energy-iot/meshems/hardware/ems-carrier/docs/ems-carrier-3d.png

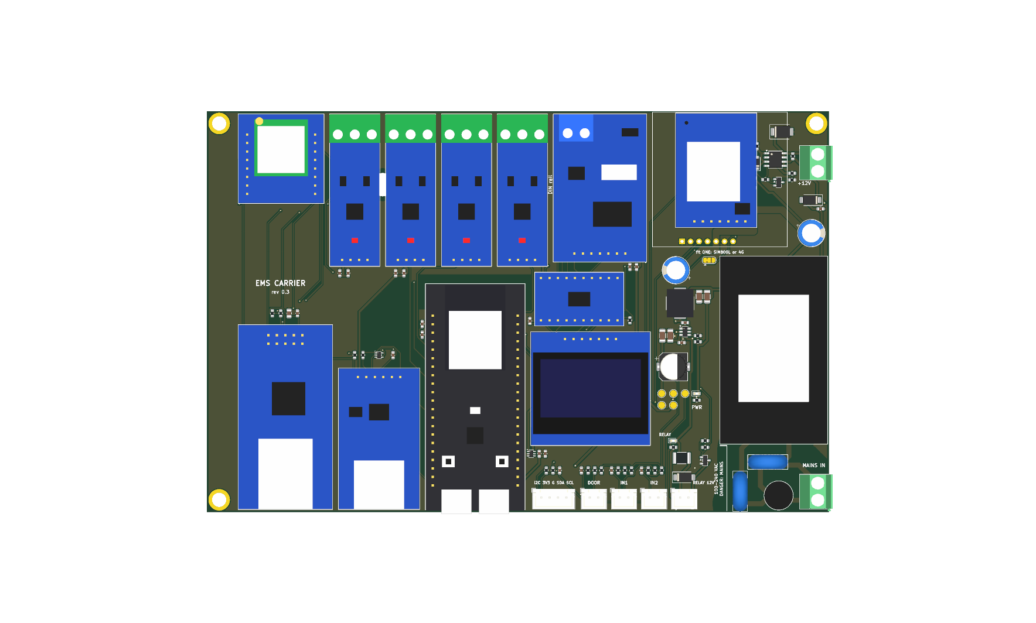
hardware/ems-carrier/docs/ems-carrier-3d.png
