energy-iot/meshems/hardware/ems-carrier/docs/ems-carrier-routed.png

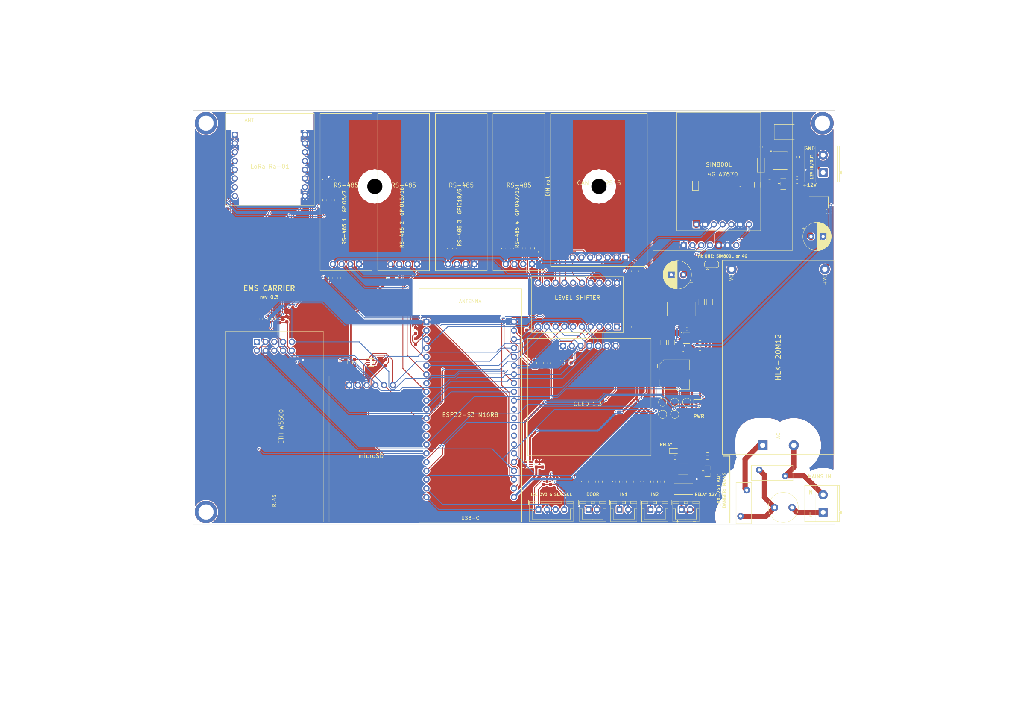
hardware/ems-carrier/docs/ems-carrier-routed.png
