energy-iot/meshems/hardware/ems-carrier/docs/images/ems-carrier-3d-bare.png

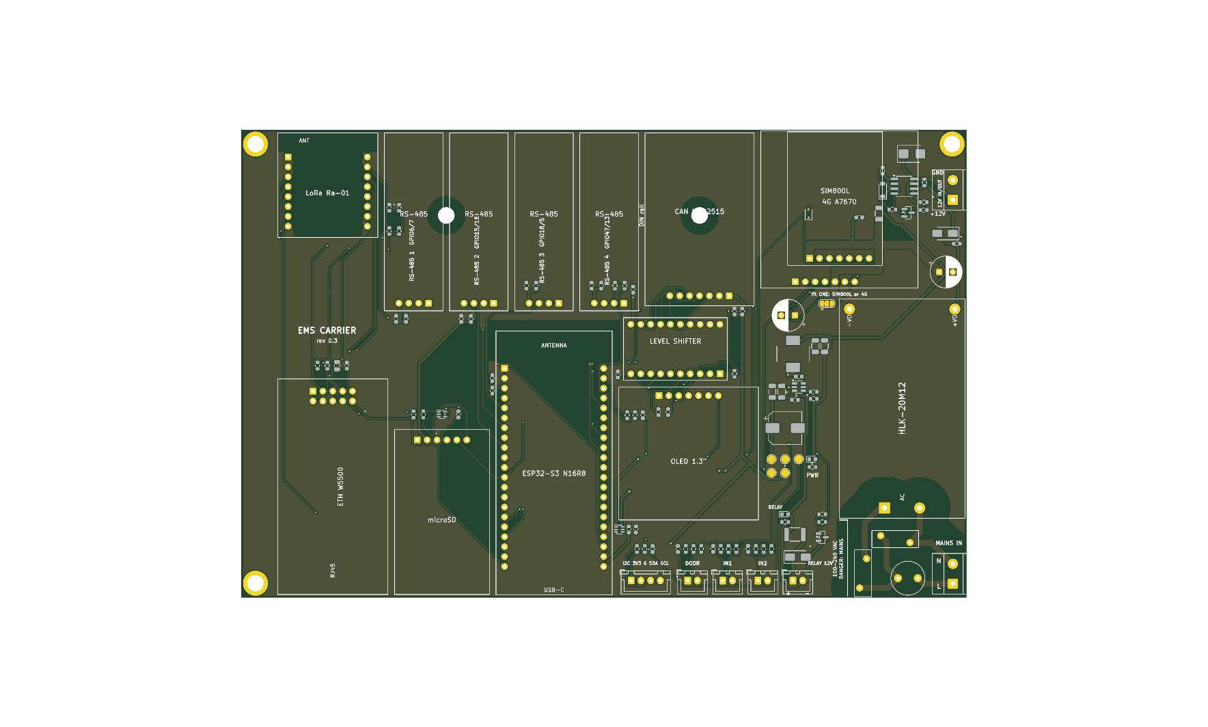
hardware/ems-carrier/docs/images/ems-carrier-3d-bare.png
