energy-iot/meshems/hardware/ems-carrier/fab/bom-jlc.csv

Comment | Designator | Footprint | LCSC Part #
100n | C1,C5,C6,C10,C12,C13,C14,C15,C17,C19,C21,C23,C25,C28,C29,C30,C34,C35,C36,C37,C38,C39 | C_0603_1608Metric | C14663
470u 25V polymer | C2 | CP_Elec_8x10 | C46550466
4.7u 50V | C3,C4 | C_1206_3216Metric | C29823
22u 25V | C7,C8 | C_1206_3216Metric | C12891
10u | C9,C11,C16,C18,C20,C22,C24,C26,C31 | C_0603_1608Metric | C19702
22u | C27 | C_0805_2012Metric | C45783
1000u 10V polymer | C32,C33 | CP_Radial_D8.0mm_P3.50mm | C49232899
SS54 | D1 | D_SMA | C22452
SMBJ16CA | D2 | D_SMB | C113990
BZT52C12 | D3 | D_SOD-123 | C173429
PWR | D4 | LED_0603_1608Metric | C12624
BAT54WS | D5 | D_SOD-323 | C3040452
SS14 | D6 | D_SMA | C2480
RELAY | D7 | LED_0603_1608Metric | C2286
T2A 250V | F1 | Fuse_Littelfuse_372_D8.50mm | C142678
PTC 0.5A 30V | F2 | Fuse_1812_4532Metric | C12559
MAINS L/N/12V IN/OUT | J1,J2 | TerminalBlock_Phoenix_MKDS-1,5-2-5.08_1x02_P5.08mm_Horizontal | C474952
DOOR... | J3,J4,J5,J7 | JST_XH_B2B-XH-A_1x02_P2.50mm_Vertical | C158012
I2C | J6 | JST_XH_B4B-XH-A_1x04_P2.50mm_Vertical | C144395
6.8uH | L1 | L_PROD_PSPMAA0805 | C2962884
HLK-20M12 | PS1 | Converter_ACDC_HLK-20Mxx | C465408
AO4805 | Q1 | SOIC-8_3.9x4.9mm_P1.27mm | C5183840
2N7002 | Q2 | SOT-23 | C8545
AO3400A | Q3 | SOT-23 | C20917
100k | R1,R3,R4,R5,R15,R33 | R_0603_1608Metric | C25803
47k | R2 | R_0603_1608Metric | C25819
73.2k 0.1% | R6 | R_0603_1608Metric | C862276
10k 0.1% | R7 | R_0603_1608Metric | C95204
1k | R8,R13 | R_0603_1608Metric | C21190
10k | R9,R12,R14,R16,R17,R19 | R_0603_1608Metric | C25804
2.2k | R10,R21,R24,R27 | R_0603_1608Metric | C4190
3.9k | R11 | R_0603_1608Metric | C23018
0.1R 1206 | R18 | R_1206_3216Metric | C25334
8.2k | R20 | R_0603_1608Metric | C25981
2.4k | R22 | R_0603_1608Metric | C22940
220 | R23,R26,R29 | R_0603_1608Metric | C22962
5.6k | R25 | R_0603_1608Metric | C23189
13k | R28 | R_0603_1608Metric | C22797
4.7k | R30,R31,R34 | R_0603_1608Metric | C23162
100 | R32 | R_0603_1608Metric | C22775
NTC 5D-9 | RT1 | RV_Disc_D12mm_W4.4mm_P7.5mm | C332361
10D561K | RV1 | RV_Disc_D12mm_W4.4mm_P7.5mm | C2839517
LMR51430XF | U1 | SOT-23-6 | C5219260
LM66100 | U2 | SOT-363_SC-70-6 | C2869734
W5500 module | U11 | W5500_Module_2x05 | C32713306
74LVC1G125 | U13 | SOT-353_SC-70-5 | C52140430
