energy-iot/meshems/hardware/ems-carrier/fab/ems-carrier.step

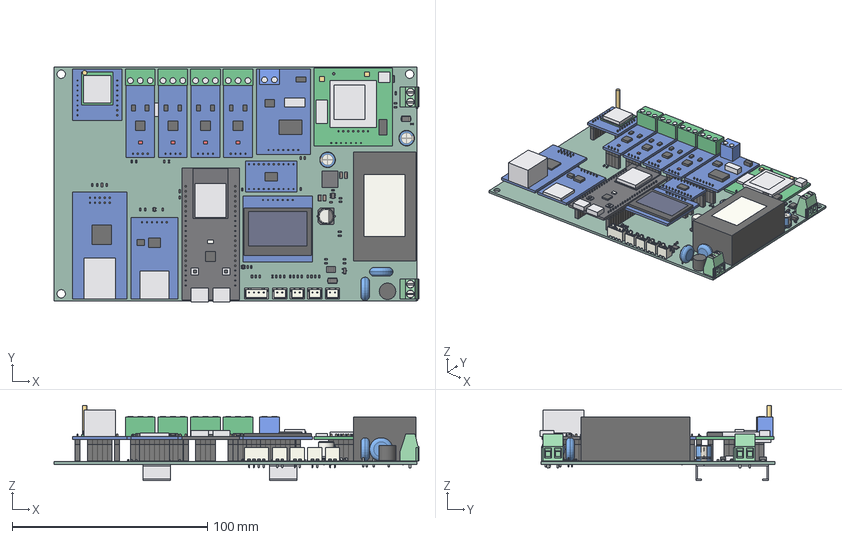
[picture p12: CAD file, 2026-11-11]
hardware/ems-carrier/fab/ems-carrier.step
187.1 x 120.5 x 38.6 mm
JST_B4B_XH_A
C_0603_1608Metric x 31
R_0603_1608Metric x 33
LED_0603_1608Metric x 2
RV_Disc_D12mm_W44mm_P75mm x 2
DIN_Clip_Bud_DNC-4796 0 x 2
HW-519_RS485_Module_1x4 0 x 4
HW-519_RS485_Module_1x4 1 x 4
HW-519_RS485_Module_1x4 2 x 4
HW-519_RS485_Module_1x4 3 x 4
HW-519_RS485_Module_1x4 4 x 4
HW-519_RS485_Module_1x4 5 x 4
HW-519_RS485_Module_1x4 6 x 4
SOT-363_SC-70-6
OLED_1.3in_SPI_1x7 0
OLED_1.3in_SPI_1x7 1
OLED_1.3in_SPI_1x7 2
OLED_1.3in_SPI_1x7 3
OLED_1.3in_SPI_1x7 4
OLED_1.3in_SPI_1x7 5
TXS0108E_Module_2x10_W12.7mm 0
TXS0108E_Module_2x10_W12.7mm 1
TXS0108E_Module_2x10_W12.7mm 2
TXS0108E_Module_2x10_W12.7mm 3
W5500_Module_2x05 0
W5500_Module_2x05 1
W5500_Module_2x05 2
W5500_Module_2x05 3
W5500_Module_2x05 4
CP_Radial_D80mm_P350mm x 2
Converter_ACDC_HLK-20Mxx 0
Converter_ACDC_HLK-20Mxx 1
SOT-23 x 2
Fuse_Littelfuse_372_D8.50mm 0
SIM800L_EVB_1x7 0
SIM800L_EVB_1x7 1
SIM800L_EVB_1x7 2
SIM800L_EVB_1x7 3
SIM800L_EVB_1x7 4
C_0805_2012Metric
SOIC-8_3.9x4.9mm_P1.27mm
SOT-23-6
TerminalBlock_Phoenix_MKDS-1,5-2-5.08_1x02_P5.08mm_Horizontal x 2
D_SMA x 2
Ra-01_Adapter_2x1x8_W20.32mm 0
Ra-01_Adapter_2x1x8_W20.32mm 1
Ra-01_Adapter_2x1x8_W20.32mm 2
Ra-01_Adapter_2x1x8_W20.32mm 3
Ra-01_Adapter_2x1x8_W20.32mm 4
Ra-01_Adapter_2x1x8_W20.32mm 5
C_1206_3216Metric x 4
JST_B2B_XH_A x 4
L_PROD_PSPMAA0805 0
D_SMB
ESP32-S3_DevBoard_2x21_W25.4mm 0
ESP32-S3_DevBoard_2x21_W25.4mm 1
ESP32-S3_DevBoard_2x21_W25.4mm 2
ESP32-S3_DevBoard_2x21_W25.4mm 3
ESP32-S3_DevBoard_2x21_W25.4mm 4
ESP32-S3_DevBoard_2x21_W25.4mm 5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
