energy-iot/meshems/(threads)

Thread 4 (2025-04-21):

Leakage Monitoring

axmsoftware, 2025-04-21:
work with leakage sensor and metering data to create OPENAMI  RCD  Leakage monitoring and command and control 2 way mqtt  - “rcd” or “leakage” subtopic.

Publish every 15 minutes per EMS. this class feeds into OPENAMI top level as new subtopic reporting and alerting leakage . Consider supporting some persistent data so can run a rule if leakage is changing over time then ralays e call to action alert.

Thread 6 (2025-04-21):

Meter Integration

axmsoftware, 2025-04-21:
Create a Meter DDS328 modbus device type class that has the modbus register suite declared and some supporting methods for loop data collection, openami subtopic structure to mqtt -different subtopics should publish at different rates , and oled UX  summary, and a diagnostic test method for each modbus device that can map to a diagnostic test button for example -? Just need framework as let workshop developers form teams around code energy iot challenges. Use Chatgpt or equiv to create a framework class and ingest the mfr’s PDF of the register set to create a code Class framework. Class should include putter and getter methods.  a few registers to be frequently queried as part of  a diagnostic method (leave empty for hackathon developer to fill in)

Thread 8 (2025-04-21):

Policy Watcher - ESP32S3 policy watch loop

axmsoftware, 2025-04-21:
Create a policy watch loop that is able to receive or defaults each tenant to a time of use entry policy overwatch.
If it detect over policy then can send alerts , if persists then can cut power after certain time.

Thread 9 (2025-04-21):

Policy Watcher - Flexmeasure ESP32S3 fan-in

axmsoftware, 2025-04-21:
Create a[ Flexmeasures ](https://github.com/flexmeasures/)fanin policy enforcement controller time of use based policy enforcements

To Help Glenn Algie and Doug MEndonca have put a detailed design code framework together using ChatGPT training of FLexmeasures.
It can be found here on[ Google shared docs](https://docs.google.com/document/d/1WiTW9lSyz2ARrED2CXFrpDBbTb_VonN_YJp-jVFDumc/edit?usp=sharing)

Thread 13 (2025-09-01):

Hardware Stability and Sustainability

axmsoftware, 2025-09-01:
There were in total 15 meshEMS HW gateways developed for the Energy Hackathon back in April.
Those were put together with volunteer work by hand by NESL.energy and Ampra Grid.
The defect rate reported was at 20% which has prompted an evaluation of the design so it can scale better and the defect rate can be reduced if not eliminated.

This is a top-level issue to record and prioritize issues related to the gateway design, repeatability and sustainability in the face of evolving supply chains and tariff challenges.
