energy-iot/meshems/hardware/ems-carrier/kicad/ems-carrier.kicad_pcb

## KiCad design hardware/ems-carrier/kicad/ems-carrier.kicad_pcb (2026-11-11)

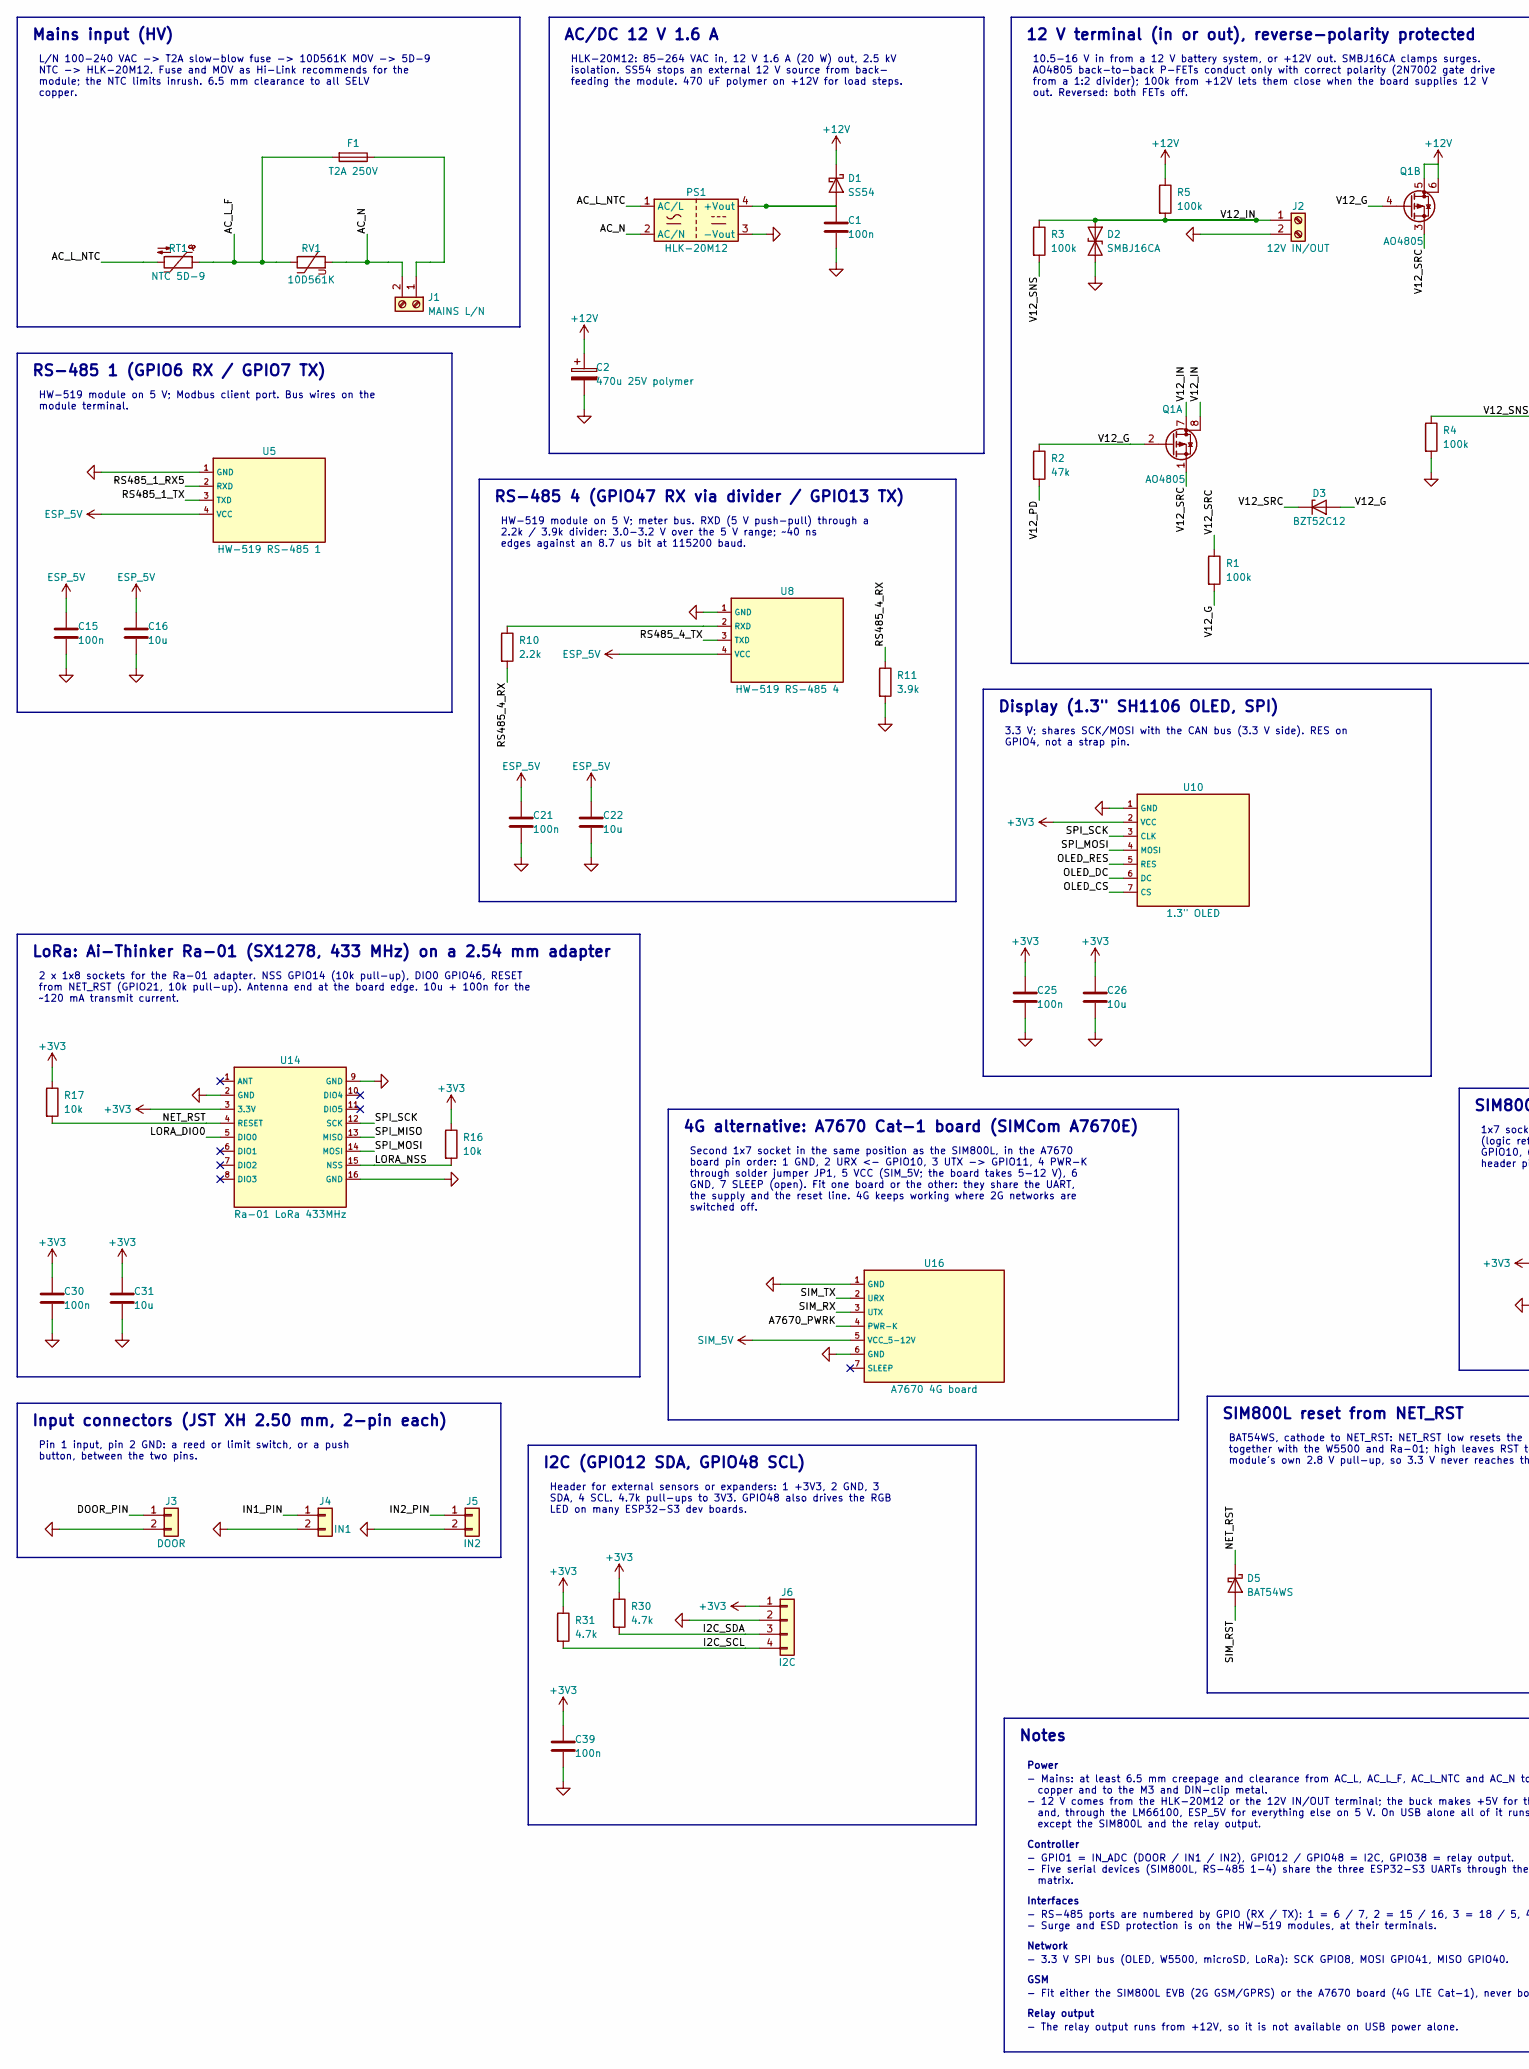
[picture p39: schematic ems-carrier.kicad_sch, EMS carrier, part in row 1, column 1]

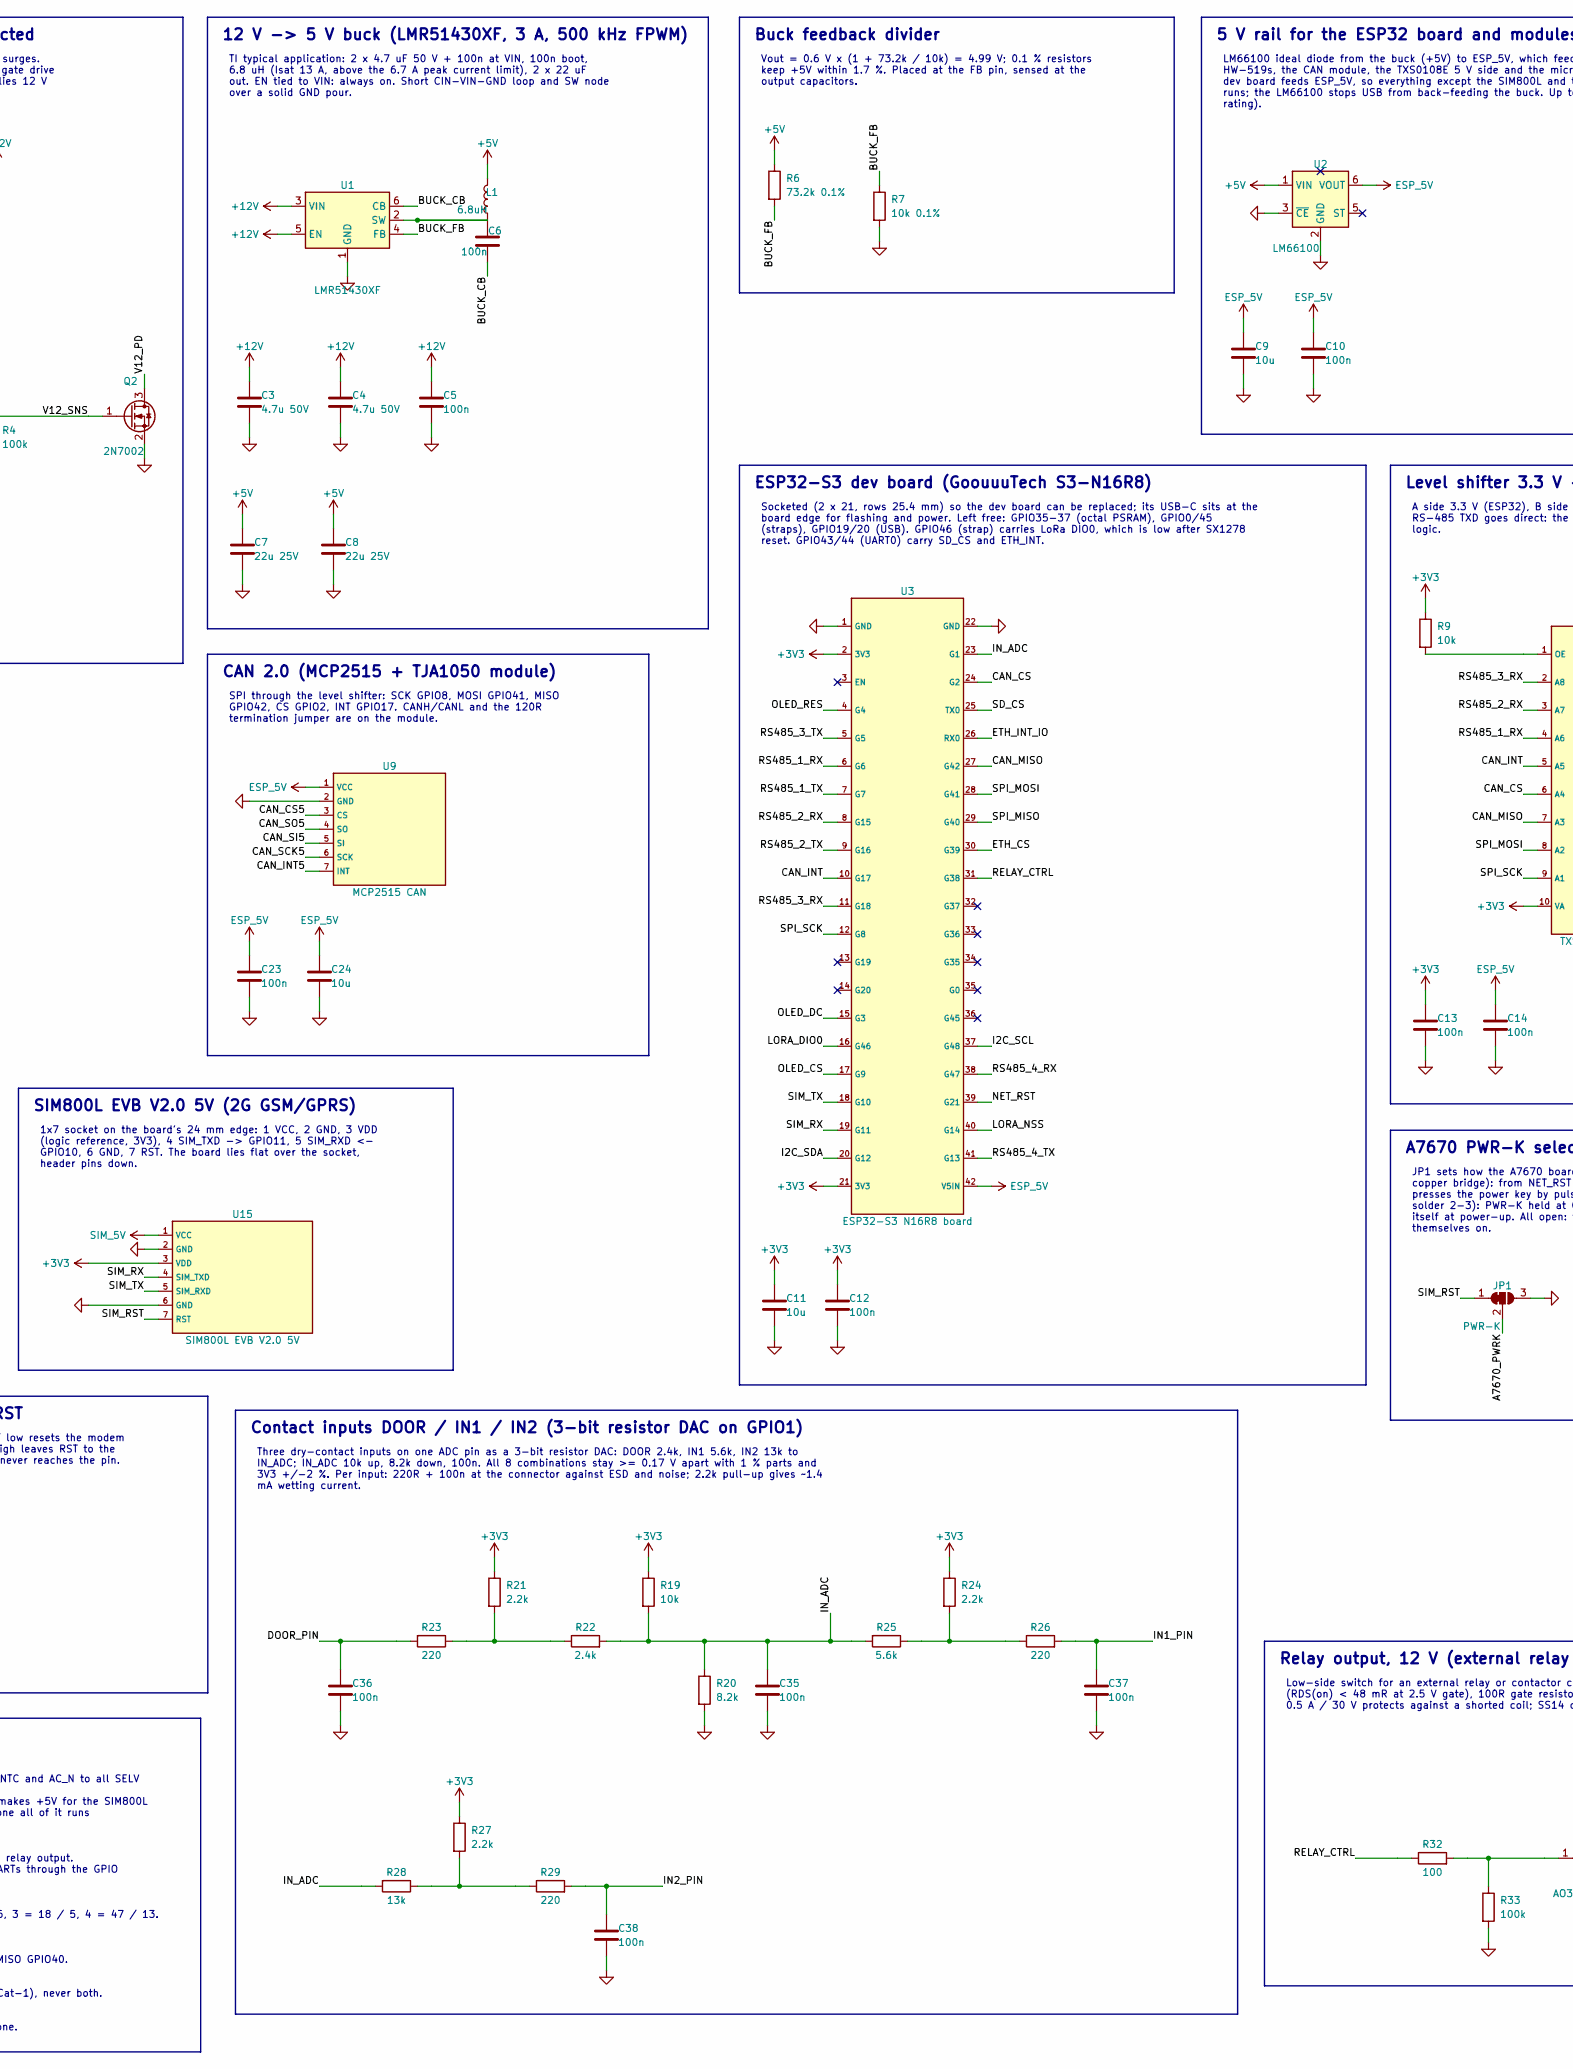
[picture p40: schematic ems-carrier.kicad_sch, EMS carrier, part in row 1, column 2]

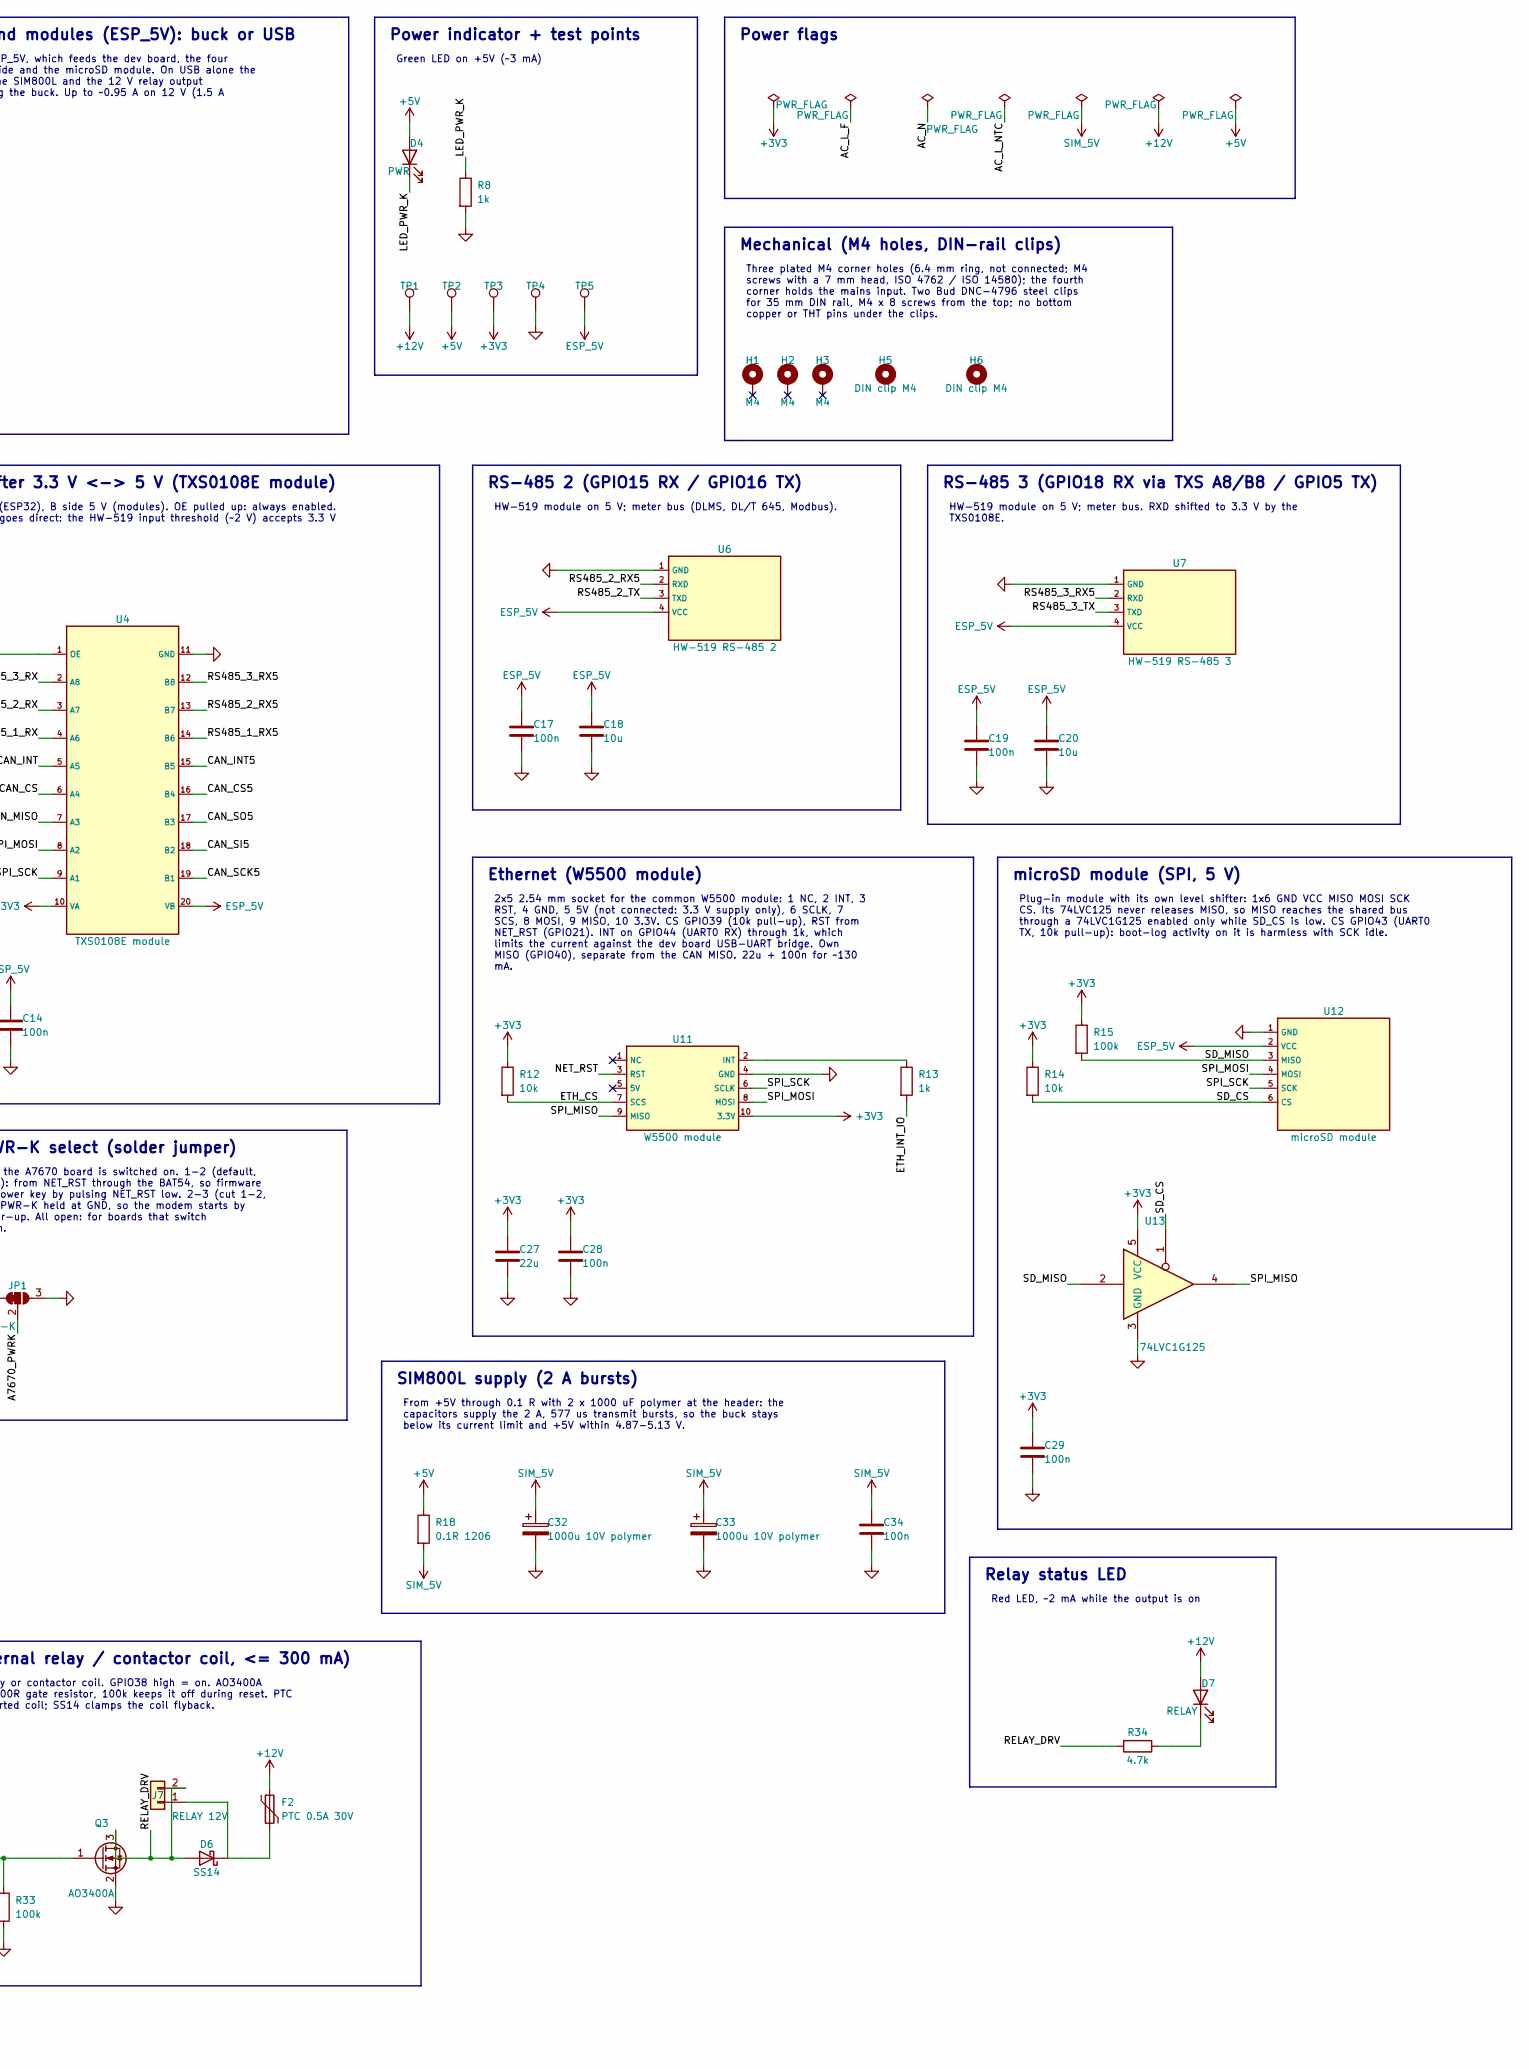
[picture p41: schematic ems-carrier.kicad_sch, EMS carrier, part in row 1, column 3]

Parts:
C1, C5, C6, C10, C12, C13, C14, C15, C17, C19, C21, C23, C25, C28, C29, C30, C34, C35, C36, C37, C38, C39: 100n; C_0603_1608Metric; LCSC C14663
C2: 470u 25V polymer; CP_Elec_8x10; MPN jieerrui MA25V470M8x10 (polymer, 25 mR); LCSC C46550466
C3, C4: 4.7u 50V; C_1206_3216Metric; LCSC C29823
C7, C8: 22u 25V; C_1206_3216Metric; LCSC C12891
C9, C11, C16, C18, C20, C22, C24, C26, C31: 10u; C_0603_1608Metric; LCSC C19702
C27: 22u; C_0805_2012Metric; LCSC C45783
C32, C33: 1000u 10V polymer; CP_Radial_D8.0mm_P3.50mm; MPN jieerrui PA10V1000M8X11 (polymer, 14 mR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; LCSC C49232899
D1: SS54; D_SMA; LCSC C22452
D2: SMBJ16CA; D_SMB; LCSC C113990
D3: BZT52C12; D_SOD-123; LCSC C173429
D4: PWR; LED_0603_1608Metric; LCSC C12624
D5: BAT54WS; D_SOD-323; LCSC C3040452
D6: SS14; D_SMA; LCSC C2480
D7: RELAY; LED_0603_1608Metric; LCSC C2286
F1: T2A 250V; Fuse_Littelfuse_372_D8.50mm; MPN Littelfuse 39212000000 (TR5 time-lag 2 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; LCSC C142678
F2: PTC 0.5A 30V; Fuse_1812_4532Metric; MPN RUILON SMD1812P050TF/30 (0.5 A hold, 1 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; LCSC C12559
H1, H2, H3: M4; MountingHole_4.3mm_M4_Pad6.4
H5, H6: DIN clip M4; DIN_Clip_Bud_DNC-4796
J1: MAINS L/N; TerminalBlock_Phoenix_MKDS-1,5-2-5.08_1x02_P5.08mm_Horizont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; LCSC C474952
J2: 12V IN/OUT; TerminalBlock_Phoenix_MKDS-1,5-2-5.08_1x02_P5.08mm_Horizont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; LCSC C474952
J3: DOOR; JST_XH_B2B-XH-A_1x02_P2.50mm_Vertical; MPN JST B2B-XH-A(LF)(SN); LCSC C158012
J4: IN1; JST_XH_B2B-XH-A_1x02_P2.50mm_Vertical; MPN JST B2B-XH-A(LF)(SN); LCSC C158012
J5: IN2; JST_XH_B2B-XH-A_1x02_P2.50mm_Vertical; MPN JST B2B-XH-A(LF)(SN); LCSC C158012
J6: I2C; JST_XH_B4B-XH-A_1x04_P2.50mm_Vertical; MPN JST B4B-XH-A(LF)(SN); LCSC C144395
J7: RELAY 12V; JST_XH_B2B-XH-A_1x02_P2.50mm_Vertical; MPN JST B2B-XH-A(LF)(SN); LCSC C158012
JP1: PWR-K; SolderJumper-3_P1.3mm_Bridged12_RoundedPad1.0x1.5mm
L1: 6.8uH; L_PROD_PSPMAA0805; MPN PROD PSPMAA0805-6R8M-ANP (19 mR, Isat 1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; LCSC C2962884
PS1: HLK-20M12; Converter_ACDC_HLK-20Mxx; LCSC C465408
Q1: AO4805; SOIC-8_3.9x4.9mm_P1.27mm; LCSC C5183840
Q2: 2N7002; SOT-23; LCSC C8545
Q3: AO3400A; SOT-23; LCSC C20917
R1, R3, R4, R5, R15, R33: 100k; R_0603_1608Metric; LCSC C25803
R2: 47k; R_0603_1608Metric; LCSC C25819
R6: 73.2k 0.1%; R_0603_1608Metric; LCSC C862276
R7: 10k 0.1%; R_0603_1608Metric; LCSC C95204
R8, R13: 1k; R_0603_1608Metric; LCSC C21190
R9, R12, R14, R16, R17, R19: 10k; R_0603_1608Metric; LCSC C25804
R10, R21, R24, R27: 2.2k; R_0603_1608Metric; LCSC C4190
R11: 3.9k; R_0603_1608Metric; LCSC C23018
R18: 0.1R 1206; R_1206_3216Metric; MPN UNI-ROYAL 1206W4F100LT5E (0.25 W); LCSC C25334
R20: 8.2k; R_0603_1608Metric; LCSC C25981
R22: 2.4k; R_0603_1608Metric; LCSC C22940
R23, R26, R29: 220; R_0603_1608Metric; LCSC C22962
R25: 5.6k; R_0603_1608Metric; LCSC C23189
R28: 13k; R_0603_1608Metric; LCSC C22797
R30, R31, R34: 4.7k; R_0603_1608Metric; LCSC C23162
R32: 100; R_0603_1608Metric; LCSC C22775
RT1: NTC 5D-9; RV_Disc_D12mm_W4.4mm_P7.5mm; MPN Hongzhi 5D-9 (5 R, 3 A, 9 mm disc, P 7.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; LCSC C332361
RV1: 10D561K; RV_Disc_D12mm_W4.4mm_P7.5mm; LCSC C2839517
TP1: +12V; TestPoint_Pad_D2.0mm
TP2: +5V; TestPoint_Pad_D2.0mm
TP3: +3V3; TestPoint_Pad_D2.0mm
TP4: GND; TestPoint_Pad_D2.0mm
TP5: ESP_5V; TestPoint_Pad_D2.0mm
U1: LMR51430XF; SOT-23-6; LCSC C5219260
U2: LM66100; SOT-363_SC-70-6; LCSC C2869734
U3: ESP32-S3 N16R8 board; ESP32-S3_DevBoard_2x21_W25.4mm
U4: TXS0108E module; TXS0108E_Module_2x10_W12.7mm
U5: HW-519 RS-485 1; HW-519_RS485_Module_1x4
U6: HW-519 RS-485 2; HW-519_RS485_Module_1x4
U7: HW-519 RS-485 3; HW-519_RS485_Module_1x4
U8: HW-519 RS-485 4; HW-519_RS485_Module_1x4
U9: MCP2515 CAN; MCP2515_CAN_Module_1x7
U10: 1.3" OLED; OLED_1.3in_SPI_1x7
U11: W5500 module; W5500_Module_2x05; LCSC C32713306
U12: microSD module; microSD_Module_1x6
U13: 74LVC1G125; SOT-353_SC-70-5; LCSC C52140430
U14: Ra-01 LoRa 433MHz; Ra-01_Adapter_2x1x8_W20.32mm
U15: SIM800L EVB V2.0 5V; SIM800L_EVB_1x7
U16: A7670 4G board; A7670_4G_Board_1x7

Connections:
+3V3: C11.1, C12.1, C13.1, C25.1, C26.1, C27.1, C28.1, C29.1, C30.1, C31.1, C39.1, J6.1, R9.1, R12.1, R14.1, R15.1, R16.1, R17.1, R19.1, R21.1, R24.1, R27.1, R30.1, R31.1, TP3.1, U3.2 (3V3), U3.21 (3V3), U4.10 (VA), U10.2 (VCC), U11.10 (3.3V), U13.5 (VCC), U14.3 (3.3V), U15.3 (VDD)
+5V: C7.1, C8.1, D4.2 (A), L1.2, R6.1, R18.1, TP2.1, U2.1 (VIN)
+12V: C2.1, C3.1, C4.1, C5.1, D1.1 (K), D7.2 (A), F2.1, Q1.5 (D), Q1.6 (D), R5.1, TP1.1, U1.3 (VIN), U1.5 (EN)
/A7670_PWRK: JP1.2 (C), U16.4 (PWR-K)
/AC_L_F: F1.2, RT1.1, RV1.1
/AC_L_NTC: PS1.1 (AC/L), RT1.2
/AC_N: J1.2, PS1.2 (AC/N), RV1.2
/BUCK_CB: C6.1, U1.6 (CB)
/BUCK_FB: R6.2, R7.1, U1.4 (FB)
/CAN_CS: U3.24 (G2), U4.6 (A4)
/CAN_CS5: U4.16 (B4), U9.3 (CS)
/CAN_INT: U3.10 (G17), U4.5 (A5)
/CAN_INT5: U4.15 (B5), U9.7 (INT)
/CAN_MISO: U3.27 (G42), U4.7 (A3)
/CAN_SCK5: U4.19 (B1), U9.6 (SCK)
/CAN_SI5: U4.18 (B2), U9.5 (SI)
/CAN_SO5: U4.17 (B3), U9.4 (SO)
/DOOR_PIN: C36.1, J3.1, R23.2
/ETH_CS: R12.2, U3.30 (G39), U11.7 (SCS)
/ETH_INT_IO: R13.2, U3.26 (RX0)
/I2C_SCL: J6.4, R31.2, U3.37 (G48)
/I2C_SDA: J6.3, R30.2, U3.20 (G12)
/IN1_PIN: C37.1, J4.1, R26.2
/IN2_PIN: C38.1, J5.1, R29.2
/IN_ADC: C35.1, R19.2, R20.1, R22.2, R25.2, R28.2, U3.23 (G1)
/LED_PWR_K: D4.1 (K), R8.1
/LORA_DIO0: U3.16 (G46), U14.5 (DIO0)
/LORA_NSS: R16.2, U3.40 (G14), U14.15 (NSS)
/NET_RST: D5.1 (K), R17.2, U3.39 (G21), U11.3 (RST), U14.4 (RESET)
/OLED_CS: U3.17 (G9), U10.7 (CS)
/OLED_DC: U3.15 (G3), U10.6 (DC)
/OLED_RES: U3.4 (G4), U10.5 (RES)
/RELAY_CTRL: R32.1, U3.31 (G38)
/RELAY_DRV: D6.2 (A), J7.2, Q3.3 (D), R34.2
/RS485_1_RX: U3.6 (G6), U4.4 (A6)
/RS485_1_RX5: U4.14 (B6), U5.2 (RXD)
/RS485_1_TX: U3.7 (G7), U5.3 (TXD)
/RS485_2_RX: U3.8 (G15), U4.3 (A7)
/RS485_2_RX5: U4.13 (B7), U6.2 (RXD)
/RS485_2_TX: U3.9 (G16), U6.3 (TXD)
/RS485_3_RX: U3.11 (G18), U4.2 (A8)
/RS485_3_RX5: U4.12 (B8), U7.2 (RXD)
/RS485_3_TX: U3.5 (G5), U7.3 (TXD)
/RS485_4_RX: R10.2, R11.1, U3.38 (G47)
/RS485_4_TX: U3.41 (G13), U8.3 (TXD)
/SD_CS: R14.2, U3.25 (TX0), U12.6 (CS), U13.1
/SD_MISO: R15.2, U12.3 (MISO), U13.2
/SIM_RST: D5.2 (A), JP1.1 (A), U15.7 (RST)
/SIM_RX: U3.19 (G11), U15.4 (SIM_TXD), U16.3 (UTX)
/SIM_TX: U3.18 (G10), U15.5 (SIM_RXD), U16.2 (URX)
/SPI_MISO: U3.29 (G40), U11.9 (MISO), U13.4, U14.13 (MISO)
/SPI_MOSI: U3.28 (G41), U4.8 (A2), U10.4 (MOSI), U11.8 (MOSI), U12.4 (MOSI), U14.14 (MOSI)
/SPI_SCK: U3.12 (G8), U4.9 (A1), U10.3 (CLK), U11.6 (SCLK), U12.5 (SCK), U14.12 (SCK)
/V12_G: D3.2 (A), Q1.2 (G), Q1.4 (G), R1.2, R2.1
/V12_IN: D2.1 (A1), J2.1, Q1.7 (D), Q1.8 (D), R3.1, R5.2
/V12_PD: Q2.3 (D), R2.2
/V12_SNS: Q2.1 (G), R3.2, R4.1
/V12_SRC: D3.1 (K), Q1.1 (S), Q1.3 (S), R1.1
ESP_5V: C9.1, C10.1, C14.1, C15.1, C16.1, C17.1, C18.1, C19.1, C20.1, C21.1, C22.1, C23.1, C24.1, TP5.1, U2.6 (VOUT), U3.42 (V5IN), U4.20 (VB), U5.4 (VCC), U6.4 (VCC), U7.4 (VCC), U8.4 (VCC), U9.1 (VCC), U12.2 (VCC)
GND: C1.2, C2.2, C3.2, C4.2, C5.2, C7.2, C8.2, C9.2, C10.2, C11.2, C12.2, C13.2, C14.2, C15.2, C16.2, C17.2, C18.2, C19.2, C20.2, C21.2, C22.2, C23.2, C24.2, C25.2, C26.2, C27.2, C28.2, C29.2, C30.2, C31.2, C32.2, C33.2, C34.2, C35.2, C36.2, C37.2, C38.2, C39.2, D2.2 (A2), J2.2, J3.2, J4.2, J5.2, J6.2, JP1.3 (B), PS1.3 (-Vout), Q2.2 (S), Q3.2 (S), R4.2, R7.2, R8.2, R11.2, R20.2, R33.2, TP4.1, U1.1 (GND), U2.2 (GND), U2.3 (~CE), U3.1 (GND), U3.22 (GND), U4.11 (GND), U5.1 (GND), U6.1 (GND), U7.1 (GND), U8.1 (GND), U9.2 (GND), U10.1 (GND), U11.4 (GND), U12.1 (GND), U13.3 (GND), U14.2 (GND), U14.9 (GND), U14.16 (GND), U15.2 (GND), U15.6 (GND), U16.1 (GND), U16.6 (GND)
unnamed: C1.1, D1.2 (A), PS1.4 (+Vout)
unnamed: D6.1 (K), F2.2, J7.1
unnamed: D7.1 (K), R34.1
unnamed: F1.1, J1.1
unnamed: Q3.1 (G), R32.2, R33.1
unnamed: R21.2, R22.1, R23.1
unnamed: R24.2, R25.1, R26.1
unnamed: R27.2, R28.1, R29.1
unnamed: C6.2, L1.1, U1.2 (SW)
unnamed: R9.2, U4.1 (OE)
unnamed: R10.1, U8.2 (RXD)
unnamed: R13.1, U11.2 (INT)
SIM_5V: C32.1, C33.1, C34.1, R18.2, U15.1 (VCC), U16.5 (VCC_5-12V)

Notes on the sheet:
Mains input (HV)
L/N 100-240 VAC -> T2A slow-blow fuse -> 10D561K MOV -> 5D-9 NTC -> HLK-20M12. Fuse and MOV as Hi-Link recommends for the module; the NTC limits inrush. 6.5 mm clearance to all SELV copper.
AC/DC 12 V 1.6 A
HLK-20M12: 85-264 VAC in, 12 V 1.6 A (20 W) out, 2.5 kV isolation. SS54 stops an external 12 V source from back- feeding the module. 470 uF polymer on +12V for load steps.
12 V terminal (in or out), reverse-polarity protected
10.5-16 V in from a 12 V battery system, or +12V out. SMBJ16CA clamps surges. AO4805 back-to-back P-FETs conduct only with correct polarity (2N7002 gate drive from a 1:2 divider); 100k from +12V lets them close when the board supplies 12 V out. Reversed: both FETs off.
12 V -> 5 V buck (LMR51430XF, 3 A, 500 kHz FPWM)
TI typical application: 2 x 4.7 uF 50 V + 100n at VIN, 100n boot, 6.8 uH (Isat 13 A, above the 6.7 A peak current limit), 2 x 22 uF out. EN tied to VIN: always on. Short CIN-VIN-GND loop and SW node over a solid GND pour.
Buck feedback divider
Vout = 0.6 V x (1 + 73.2k / 10k) = 4.99 V; 0.1 % resistors keep +5V within 1.7 %. Placed at the FB pin, sensed at the output capacitors.
5 V rail for the ESP32 board and modules (ESP_5V): buck or USB
LM66100 ideal diode from the buck (+5V) to ESP_5V, which feeds the dev board, the four HW-519s, the CAN module, the TXS0108E 5 V side and the microSD module. On USB alone the dev board feeds ESP_5V, so everything except the SIM800L and the 12 V relay output runs; the LM66100 stops USB from back-fee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
Power indicator + test points
Green LED on +5V (~3 mA)
Power flags
Mechanical (M4 holes, DIN-rail clips)
Three plated M4 corner holes (6.4 mm ring, not connected; M4 screws with a 7 mm head, ISO 4762 / ISO 14580); the fourth corner holds the mains input. Two Bud DNC-4796 steel clips for 35 mm DIN rail, M4 x 8 screws from the top; no bottom copper or THT pins under the clips.
ESP32-S3 dev board (GoouuuTech S3-N16R8)
Socketed (2 x 21, rows 25.4 mm) so the dev board can be replaced; its USB-C sits at the board edge for flashing and power. Left free: GPIO35-37 (octal PSRAM), GPIO0/45 (straps), GPIO19/20 (USB). GPIO46 (strap) carries LoRa DIO0, which is low after SX1278 reset. GPIO43/44 (UART0) carry SD_CS and ETH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
Level shifter 3.3 V <-> 5 V (TXS0108E module)
A side 3.3 V (ESP32), B side 5 V (modules). OE pulled up: always enabled. RS-485 TXD goes direct: the HW-519 input threshold (~2 V) accepts 3.3 V logic.
RS-485 1 (GPIO6 RX / GPIO7 TX)
HW-519 module on 5 V; Modbus client port. Bus wires on the module terminal.
RS-485 2 (GPIO15 RX / GPIO16 TX)
HW-519 module on 5 V; meter bus (DLMS, DL/T 645, Modbus).
RS-485 3 (GPIO18 RX via TXS A8/B8 / GPIO5 TX)
HW-519 module on 5 V; meter bus. RXD shifted to 3.3 V by the TXS0108E.
RS-485 4 (GPIO47 RX via divider / GPIO13 TX)
HW-519 module on 5 V; meter bus. RXD (5 V push-pull) through a 2.2k / 3.9k divider: 3.0-3.2 V over the 5 V range; ~40 ns edges against an 8.7 us bit at 115200 baud.
CAN 2.0 (MCP2515 + TJA1050 module)
SPI through the level shifter: SCK GPIO8, MOSI GPIO41, MISO GPIO42, CS GPIO2, INT GPIO17. CANH/CANL and the 120R termination jumper are on the module.
Display (1.3" SH1106 OLED, SPI)
3.3 V; shares SCK/MOSI with the CAN bus (3.3 V side). RES on GPIO4, not a strap pin.
Ethernet (W5500 module)
2x5 2.54 mm socket for the common W5500 module: 1 NC, 2 INT, 3 RST, 4 GND, 5 5V (not connected: 3.3 V supply only), 6 SCLK, 7 SCS, 8 MOSI, 9 MISO, 10 3.3V. CS GPIO39 (10k pull-up), RST from NET_RST (GPIO21). INT on GPIO44 (UART0 RX) through 1k, which limits the current against the dev board USB-UAR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
microSD module (SPI, 5 V)
Plug-in module with its own level shifter: 1x6 GND VCC MISO MOSI SCK CS. Its 74LVC125 never releases MISO, so MISO reaches the shared bus through a 74LVC1G125 enabled only while SD_CS is low. CS GPIO43 (UART0 TX, 10k pull-up): boot-log activity on it is harmless with SCK idle.
LoRa: Ai-Thinker Ra-01 (SX1278, 433 MHz) on a 2.54 mm adapter
2 x 1x8 sockets for the Ra-01 adapter. NSS GPIO14 (10k pull-up), DIO0 GPIO46, RESET from NET_RST (GPIO21, 10k pull-up). Antenna end at the board edge. 10u + 100n for the ~120 mA transmit current.
SIM800L EVB V2.0 5V (2G GSM/GPRS)
1x7 socket on the board's 24 mm edge: 1 VCC, 2 GND, 3 VDD (logic reference, 3V3), 4 SIM_TXD -> GPIO11, 5 SIM_RXD <- GPIO10, 6 GND, 7 RST. The board lies flat over the socket, header pins down.
4G alternative: A7670 Cat-1 board (SIMCom A7670E)
Second 1x7 socket in the same position as the SIM800L, in the A7670 board pin order: 1 GND, 2 URX <- GPIO10, 3 UTX -> GPIO11, 4 PWR-K through solder jumper JP1, 5 VCC (SIM_5V; the board takes 5-12 V), 6 GND, 7 SLEEP (open). Fit one board or the other: they share the UART, the supply and the reset l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
A7670 PWR-K select (solder jumper)
JP1 sets how the A7670 board is switched on. 1-2 (default, copper bridge): from NET_RST through the BAT54, so firmware presses the power key by pulsing NET_RST low. 2-3 (cut 1-2, solder 2-3): PWR-K held at GND, so the modem starts by itself at power-up. All open: for boards that switch themselves o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
SIM800L supply (2 A bursts)
From +5V through 0.1 R with 2 x 1000 uF polymer at the header: the capacitors supply the 2 A, 577 us transmit bursts, so the buck stays below its current limit and +5V within 4.87-5.13 V.
SIM800L reset from NET_RST
BAT54WS, cathode to NET_RST: NET_RST low resets the modem together with the W5500 and Ra-01; high leaves RST to the module's own 2.8 V pull-up, so 3.3 V never reaches the pin.
Contact inputs DOOR / IN1 / IN2 (3-bit resistor DAC on GPIO1)
Three dry-contact inputs on one ADC pin as a 3-bit resistor DAC: DOOR 2.4k, IN1 5.6k, IN2 13k to IN_ADC; IN_ADC 10k up, 8.2k down, 100n. All 8 combinations stay >= 0.17 V apart with 1 % parts and 3V3 +/-2 %. Per input: 220R + 100n at the connector against ESD and noise; 2.2k pull-up gives ~1.4 mA w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
Input connectors (JST XH 2.50 mm, 2-pin each)
Pin 1 input, pin 2 GND: a reed or limit switch, or a push button, between the two pins.
I2C (GPIO12 SDA, GPIO48 SCL)
Header for external sensors or expanders: 1 +3V3, 2 GND, 3 SDA, 4 SCL. 4.7k pull-ups to 3V3. GPIO48 also drives the RGB LED on many ESP32-S3 dev boards.
Relay output, 12 V (external relay / contactor coil, <= 300 mA)
Low-side switch for an external relay or contactor coil. GPIO38 high = on. AO3400A (RDS(on) < 48 mR at 2.5 V gate), 100R gate resistor, 100k keeps it off during reset. PTC 0.5 A / 30 V protects against a shorted coil; SS14 clamps the coil flyback.
Relay status LED
Red LED, ~2 mA while the output is on
Notes
Power
- Mains: at least 6.5 mm creepage and clearance from AC_L, AC_L_F, AC_L_NTC and AC_N to all SELV copper and to the M3 and DIN-clip metal. - 12 V comes from the HLK-20M12 or the 12V IN/OUT terminal; the buck makes +5V for the SIM800L and, through the LM66100, ESP_5V for everything else on 5 V. On US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
Controller
- GPIO1 = IN_ADC (DOOR / IN1 / IN2), GPIO12 / GPIO48 = I2C, GPIO38 = relay output. - Five serial devices (SIM800L, RS-485 1-4) share the three ESP32-S3 UARTs through the GPIO matrix.
Interfaces
- RS-485 ports are numbered by GPIO (RX / TX): 1 = 6 / 7, 2 = 15 / 16, 3 = 18 / 5, 4 = 47 / 13. - Surge and ESD protection is on the HW-519 modules, at their terminals.
Network
- 3.3 V SPI bus (OLED, W5500, microSD, LoRa): SCK GPIO8, MOSI GPIO41, MISO GPIO40.
GSM
- Fit either the SIM800L EVB (2G GSM/GPRS) or the A7670 board (4G LTE Cat-1), never both.
Relay output
- The relay output runs from +12V, so it is not available on USB power alone.

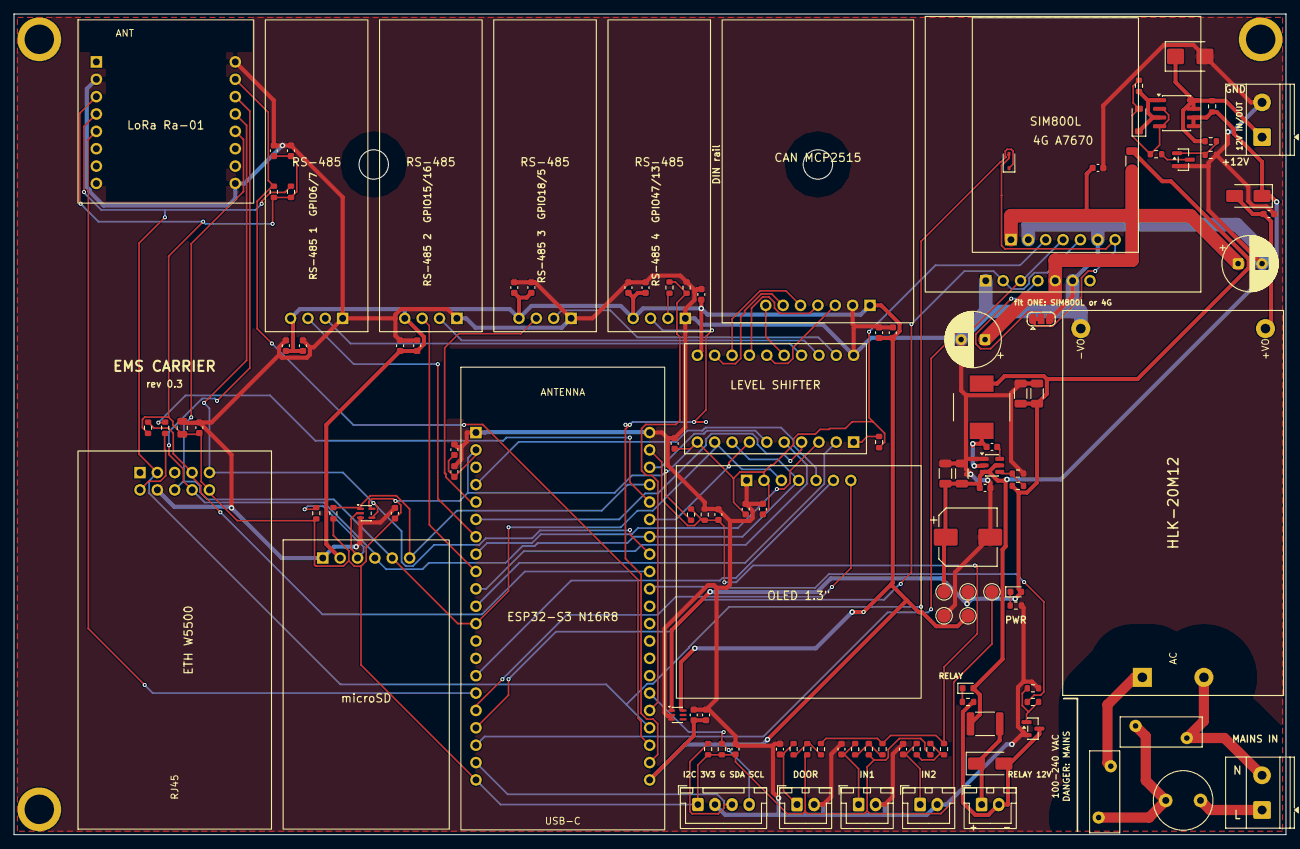
[picture p42: board ems-carrier.kicad_pcb from above]

Board: 2 copper layers, 186.0 x 120.0 mm, 123 parts (0 on the bottom side), 73 nets.
