energy-iot/meshems/(commit log)

2025-04-03 added display (SH1106 copied to lib); added console; updated pins for SPI OLED; draw rick at boot; add title and overlay to console display
2025-04-03 changed relay pin to 18 and swapped modbus 2 module rx/tx pins 15 and 16 to follow same pattern
2025-04-04 define separate SPI bus for CAN
2025-04-04 enable can on default SPI bus
2025-04-16 Added board image to README
2025-04-18 added lean-in UX of mqtt and button prompt
2025-05-05 Update README to reflect 120/240 VAC 50/60 hz supply options
2025-07-07 Update README.md
    added link for 7 pin 1.3 inch oled display
2026-07-29 Add 2026 assembly workshop guide (HTML, PDF, images)
    Energy IoT MeshEMS assembly workshop guide for the NESL EMS Controller
    PCB 865B — HTML source, distributable PDF, and the 25 build photos.
    Mirrored from the meshems-openami-metering workshop branch after the
    NESL branding review pass.
2026-07-31 First commit of new hw only repo structure for meshems
    [20260716_MeshEMS_V3_BOM_woCSEnergyMeter - BOM.csv, 20260716_MeshEMS_V3_BOM_woCSEnergyMeter.xlsx]
2026-11-11 Add EMS carrier rev 0.3: schematic, PCB, production files, views
    Socketed carrier PCB for the meshEMS dev-kit modules (ESP32-S3 dev board,
    4x HW-519 RS-485, MCP2515 CAN, TXS0108E, OLED) with W5500 Ethernet, microSD,
    Ra-01 LoRa and a cellular modem: a SIM800L EVB (2G) or an A7670 board (4G LTE
    Cat-1) in one shared position. 12 V supply from an HLK-20M12 or an external
    12 V source, 3 A buck to 5 V; the 5 V modules also run from USB. Three
    contact inputs, I2C header, 12 V relay output, three plated M4 corner holes
    and DIN-rail clips. 186 x 120 mm, 2 layers.
    KiCad 10 schematic and PCB, JLCPCB Gerbers, BOM and placement files,
    schematic PDF, annotated top views and 3D renders, README. Not yet
    fa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
2026-11-11 EMS carrier: tidy the PR folder
    Neutral wording in part fields and library descriptions, unused footprints
    (HLK-10M05, Omron SSR) and the SSR symbol removed, duplicate fab outputs
    removed (loose Gerbers identical to the zip, KiCad position file), stock and
    price snapshot removed, README file list updated.
